OSU-LRAM/DASHBoard/ATxMega64A4U_DASH/README.txt

Bluetooth Device ID:
RNBT-990E

Authentification is:
1234
