OSU-LRAM/DASHBoard/ATxMega64A4U_DASH/Final Bill of Materials.xlsx

MDrive BOM
Component | Part # | Supplier PN | Supplier | Quanity needed | Price for 100 | TOTAL
Motor Driver | DRV8835DSSR | 296-30391-1-ND (http://www.digikey.com/product-detail/en/texas-instruments/DRV8835DSSR/296-30391-1-ND/3188673) | Digikey | 1 | 1.3797 | 1.3797
P-CH Mosfet | MTM231232LBF | MTM231232LBFCT-ND (http://www.digikey.com/product-detail/en/panasonic-electronic-components/MTM231232LBF/MTM231232LBFCT-ND/4864487) | Digikey | 1 | 0.2214 | 0.2214
Motor Header | SM04B-SRSS-TB(LF)(SN) | 455-1804-1-ND (http://www.digikey.com/product-detail/en/jst-sales-america-inc/SM04B-SRSS-TB(LF)(SN)/455-1804-1-ND/926875) | Digikey | 1 | 0.4360 | 0.436
MH crimp | 04SR-3S | 455-2185-ND (http://www.digikey.com/product-detail/en/04SR-3S/455-2185-ND/1300344) | Digikey | 1 | 0.2419 | 0.2419
10uF | CC0805ZKY5V6BB106 | 311-1355-1-ND (http://www.digikey.com/product-detail/en/yageo/CC0805ZKY5V6BB106/311-1355-1-ND/2103139) | Digikey | 1 | 0.0559 | 0.0559
0.1uF | CC0603ZRY5V9BB104 | 311-1343-1-ND (http://www.digikey.com/product-detail/en/yageo/CC0603ZRY5V9BB104/311-1343-1-ND/2103127) | Digikey | 1 | 0.0082 | 0.0082
33K | RC0603JR-0733KL | 311-33KGRCT-ND (http://www.digikey.com/product-detail/en/RC0603JR-0733KL/311-33KGRCT-ND/729719) | Digikey | 1 | 0.0044 | 0.0044
68K | RC0603JR-0768KL | 311-68KGRCT-ND (http://www.digikey.com/product-detail/en/yageo/RC0603JR-0768KL/311-68KGRCT-ND/729769) | Digikey | 1 | 0.0044 | 0.0044
 |  |  |  |  |  |  | 2.3519
BOM_gyro
Component | Part # | Supplier PN | Supplier | Quantity Needed | Price for 100 | Total
0.1uF Capacitor | CC0603ZRY5V9BB104 | 311-1343-1-ND (http://www.digikey.com/product-detail/en/CC0603ZRY5V9BB104/311-1343-1-ND/2103127) | Digikey | 1 | 0.0082 | 0.0082
10uF Capacitor | CC0805ZKY5V6BB106 | 311-1355-1-ND (http://www.digikey.com/product-detail/en/CC0805ZKY5V6BB106/311-1355-1-ND/2103139) | Digikey | 1 | 0.0559 | 0.0559
10nF Capacitor | CC0603KRX7R9BB103 | 311-1085-1-ND (http://www.digikey.com/product-detail/en/CC0603KRX7R9BB103/311-1085-1-ND/302995) | Digikey | 1 | 0.0081 | 0.0081
3-Axis Gyro | L3GD20HTR | 497-13931-1-ND (http://www.digikey.com/product-detail/en/stmicroelectronics/L3GD20HTR/497-13931-1-ND/4357644) | Digikey | 1 | 2.5185 | 2.5185
 |  |  |  |  |  |  | 2.5907
BOM_BT
Component | Part # | Supplier PN | Supplier | Quantity Needed | Price for 100
Bluetooth Module | RN42HID-I/RM | RN42HID-I/RM-ND (http://www.digikey.com/product-detail/en/microchip-technology/RN42HID-I%2FRM/RN42HID-I%2FRM-ND/3597485) | Digikey | 1 | 13.9624 | 13.9624
100K Resistor | ERJ-3EKF1003V | P100KHCT-ND (http://www.digikey.com/product-search/en?keywords=P100KHCT-ND) | Digikey | 2 | 0.0084 | 0.0168
470R Resistor | RC0603JR-07470RL (http://www.digikey.com/product-detail/en/RC0603JR-07470RL/311-470GRCT-ND/729738) | 311-470GRCT-ND (http://www.digikey.com/product-detail/en/RC0603JR-07470RL/311-470GRCT-ND/729738) | Digikey | 2 | 0.0044 | 0.0088
LED Red | LTST-C190CKT | 160-1181-1-ND (http://www.digikey.com/product-detail/en/LTST-C190CKT/160-1181-1-ND/269253) | Digikey | 1 | 0.1374 | 0.1374
LED Green | LTST-C190GKT | 160-1183-1-ND (http://www.digikey.com/product-detail/en/LTST-C190GKT/160-1183-1-ND/269255) | Digikey | 1 | 0.1128 | 0.1128
 |  |  |  |  |  |  | 14.2382
BOM_Batt
Component | Part # | Supplier PN | Supplier | Quantity Needed | Price for 100
Connector Header | SM02B-SRSS-TB(LF)(SN) | 455-1802-1-ND (http://www.digikey.com/product-detail/en/SM02B-SRSS-TB(LF)(SN)/455-1802-1-ND/926873) | Digikey | 1 | 0.3393 | 0.3393
Connector Receptacle | 02SR-3S | 455-2183-ND (http://www.digikey.com/product-detail/en/jst-sales-america-inc/02SR-3S/455-2183-ND/1300342) | Digikey | 1 | 0.1800 | 0.18
Battery | TP125-1SPL25UM (http://www.thunderpowerrc.com/Products/Ultra-Micro/125mAh-1-CELL-1S-3-7V-G4-PRO-LITE-25C-LIPO-ULTRA-MICRO) | TP125-1SPL25UM (http://www.thunderpowerrc.com/Products/Ultra-Micro/125mAh-1-CELL-1S-3-7V-G4-PRO-LITE-25C-LIPO-ULTRA-MICRO) | ThunderPWR | 1 | 2.9900 | 2.99
LED Green | LTST-C190GKT | 160-1183-1-ND (http://www.digikey.com/product-detail/en/LTST-C190GKT/160-1183-1-ND/269255) | Digikey | 1 | 0.1128 | 0.1128
470 resistor | RC0603JR-07470RL (http://www.digikey.com/product-detail/en/RC0603JR-07470RL/311-470GRCT-ND/729738) | 311-470GRCT-ND (http://www.digikey.com/product-detail/en/RC0603JR-07470RL/311-470GRCT-ND/729738) | Digikey | 1 | 0.0044 | 0.0044
4.7uF Capacitor | 885012106012 | 732-7909-1-ND (http://www.digikey.com/product-detail/en/885012106012/732-7909-1-ND/5454536) | Digikey | 2 | 0.1285 | 0.257
0.1uF Capacitor | CC0603ZRY5V9BB104 | 311-1343-1-ND (http://www.digikey.com/product-detail/en/CC0603ZRY5V9BB104/311-1343-1-ND/2103127) | Digikey | 1 | 0.0082 | 0.0082
10k resistor | RC0603JR-0710KL | 311-10KGRCT-ND (http://www.digikey.com/product-detail/en/RC0603JR-0710KL/311-10KGRCT-ND/729647) | Digikey | 1 | 0.0044 | 0.0044
Charging IC | MCP73831T-2ACI/OT | MCP73831T-2ACI/OTCT-ND (http://www.digikey.com/product-detail/en/MCP73831T-2ACI%2FOT/MCP73831T-2ACI%2FOTCT-ND/1979802) | Digikey | 1 | 0.4200 | 0.42
 |  |  |  |  |  |  | 4.3161
BOM_AVS
Component | Part # | Supplier PN | Supplier | Quantity Needed | Price for 100
10nF Capacitor | 885012206014 | 732-7933-1-ND (http://www.digikey.com/product-detail/en/wurth-electronics-inc/885012206014/732-7933-1-ND/5454560) | Digikey | 1 | 0.0693 | 0.0693
Ferrite Bead | BLM18AG121SN1D | 490-1011-1-ND (http://www.digikey.com/product-detail/en/murata-electronics-north-america/BLM18AG121SN1D/490-1011-1-ND/584459) | Digikey | 1 | 0.0476 | 0.0476
Micro USB | 473460001 | WM17141CT-ND (http://www.digikey.com/product-detail/en/molex-llc/0473460001/WM17141CT-ND/1782474) | Digikey | 1 | 0.7563 | 0.7563
100k Resistor | ERJ-3EKF1003V | P100KHCT-ND (http://www.digikey.com/product-search/en?keywords=P100KHCT-ND) | Digikey | 1 | 0.0084 | 0.0084
P-CH Mosfet | MTM231232LBF | MTM231232LBFCT-ND (http://www.digikey.com/product-detail/en/panasonic-electronic-components/MTM231232LBF/MTM231232LBFCT-ND/4864487) | Digikey | 1 | 0.2214 | 0.2214
Schottky Diode | SD0805S020S1R0 | 478-7800-1-ND (http://www.digikey.com/product-detail/en/avx-corporation/SD0805S020S1R0/478-7800-1-ND/3749510) | Digikey | 1 | 0.2166 | 0.2166
TVS Diode | PRTR5v0u2x | 568-4140-1-ND (http://www.digikey.com/product-detail/en/nxp-semiconductors/PRTR5V0U2X,215/568-4140-1-ND/1589981) | Digikey | 1 | 0.3347 | 0.3347
 |  |  |  |  |  |  | 1.6543
BOM_Vreg
Component | Part # | Supplier PN | Supplier | Quantity Needed | Price for 100
LED Green | LTST-C190GKT | 160-1183-1-ND (http://www.digikey.com/product-detail/en/LTST-C190GKT/160-1183-1-ND/269255) | Digikey | 1 | 0.1128 | 0.1128
Switch | JS202011SCQN | 401-2002-1-ND (http://www.digikey.com/product-detail/en/JS202011SCQN/401-2002-1-ND/1640098) | Digikey | 1 | 0.3674 | 0.3674
470 resistor | RC0603JR-07470RL (http://www.digikey.com/product-detail/en/RC0603JR-07470RL/311-470GRCT-ND/729738) | 311-470GRCT-ND (http://www.digikey.com/product-detail/en/RC0603JR-07470RL/311-470GRCT-ND/729738) | Digikey | 1 | 0.0044 | 0.0044
1uF Capcaitor | 885012206026 | 732-7945-1-ND (http://www.digikey.com/product-detail/en/885012206026/732-7945-1-ND/5454572) | Digikey | 3 | 0.0796 | 0.2388
LDO | BU33SD2MG-MTR | BU33SD2MGMCT-ND (http://www.digikey.com/product-search/en?keywords=BU33SD2MGMCT-ND) | Digikey | 1 | 0.3699 | 0.3699
 |  |  |  |  |  |  | 1.0933
BOM_Mr
Component | Part # | Supplier PN | Supplier | Quantity Needed | Price for 100
Magnetic Encoder | 2598 | Pololu (https://www.pololu.com/product/2598) | Pololu | 1 | 5.950 | 5.95
Coreless Motor |  | Amazon (http://www.amazon.com/Coreless-Motor-6x12mm-DC3-7V-45000RPM/dp/B00QC2EWUO) | Amazon | 1 | 4.510 | 4.51
Header | SM04B-SRSS-TB(LF)(SN) | 455-1804-1-ND (http://www.digikey.com/product-detail/en/jst-sales-america-inc/SM04B-SRSS-TB(LF)(SN)/455-1804-1-ND/926875) | Digikey | 2 | 0.4360 | 0.872
Header crimp | 04SR-3S | 455-2185-ND (http://www.digikey.com/product-detail/en/04SR-3S/455-2185-ND/1300344) | Digikey | 2 | 0.2419 | 0.4838
 |  |  |  |  |  |  | 11.8158
BOM_Ml
Component | Part # | Supplier PN | Supplier | Quantity Needed | Price for 100
Magnetic Encoder | 2598 | Pololu (https://www.pololu.com/product/2598) | Pololu | 1 | 5.950 | 5.95
Coreless Motor |  | Amazon (http://www.amazon.com/Coreless-Motor-6x12mm-DC3-7V-45000RPM/dp/B00QC2EWUO) | Amazon | 1 | 4.510 | 4.51
Header | SM04B-SRSS-TB(LF)(SN) | 455-1804-1-ND (http://www.digikey.com/product-detail/en/jst-sales-america-inc/SM04B-SRSS-TB(LF)(SN)/455-1804-1-ND/926875) | Digikey | 2 | 0.4360 | 0.872
Header crimp | 04SR-3S | 455-2185-ND (http://www.digikey.com/product-detail/en/04SR-3S/455-2185-ND/1300344) | Digikey | 2 | 0.2419 | 0.4838
 |  |  |  |  |  |  | 11.8158
BOM_Micro
Component | Part # | Supplier PN | Supplier | Quantity Needed | Price for 100
0.1uF Capacitor | CC0603ZRY5V9BB104 | 311-1343-1-ND (http://www.digikey.com/product-detail/en/CC0603ZRY5V9BB104/311-1343-1-ND/2103127) | Digikey | 4 | 0.0082 | 0.0328
10nH Inductor | 744786110A | 732-6263-1-ND (http://www.digikey.com/product-detail/en/744786110A/732-6263-1-ND/5087226) | Digikey | 1 | 0.0950 | 0.095
100K Resistor | ERJ-3EKF1003V | P100KHCT-ND (http://www.digikey.com/product-search/en?keywords=P100KHCT-ND) | Digikey | 2 | 0.0084 | 0.0168
Push Button | 1.14100.5030000 | CKN9363CT-ND (http://www.digikey.com/product-detail/en/1.14100.5030000/CKN9363CT-ND/583462) | Digikey | 1 | 2.0004 | 2.0004
ATXMega64 A4U | ATXMEGA64A4U-AU | ATXMEGA64A4U-AU-ND (http://www.digikey.com/product-detail/en/ATXMEGA64A4U-AU/ATXMEGA64A4U-AU-ND/4215304) | Digikey | 1 | 3.5461 | 3.5461
32 kHz Oscillator | FC-12M 32.7680KA-A3 | SER3672CT-ND (http://www.digikey.com/product-detail/en/FC-12M%2032.7680KA-A3/SER3672CT-ND/2403445) | Digikey | 1 | 1.512 | 1.512
 |  |  |  |  |  |  | 7.0753
BOM_Board
Component | Part # | Supplier PN | Supplier | Quantity Needed | Price for 100
Solder Paste | SMD291SNL | SMD291SNL-ND (http://www.digikey.com/product-detail/en/chip-quik-inc/SMD291SNL/SMD291SNL-ND/1160001) | Digikey | 1 | 15.3 | 15.3
Ribbon Cable | 3811/09 300 | MC090M-5-ND (http://www.digikey.com/product-detail/en/3811%2F09%20300/MC090M-5-ND/4312054) | Digikey | 3 | 2.862 | 8.586
Solder Stencil |  |  | OSH Stencil | 1 | 5.85 | 5.85
PCB |  |  | OSH Park | 1 | 11.67 | 11.67
 |  |  |  |  |  |  | 41.406
 |  |  |  |  |  |  | Total
 |  |  |  |  |  |  | $98.36
Substitute Parts
BT Alternate |  | 740-1038-ND (http://www.digikey.com/scripts/DkSearch/dksus.dll?Detail&itemSeq=194547669&uq=635961646551221085)
Schottky Diode Alternate (500mA) |  | 478-7799-1-ND (http://www.digikey.com/product-detail/en/avx-corporation/SD0805S020S0R5/478-7799-1-ND/3749477)
