OSU-LRAM/DASHBoard/ATxMega64A4U_DASH/PCB/DASH.brd

## EAGLE design ATxMega64A4U_DASH/PCB/DASH.brd (2016-06-20)

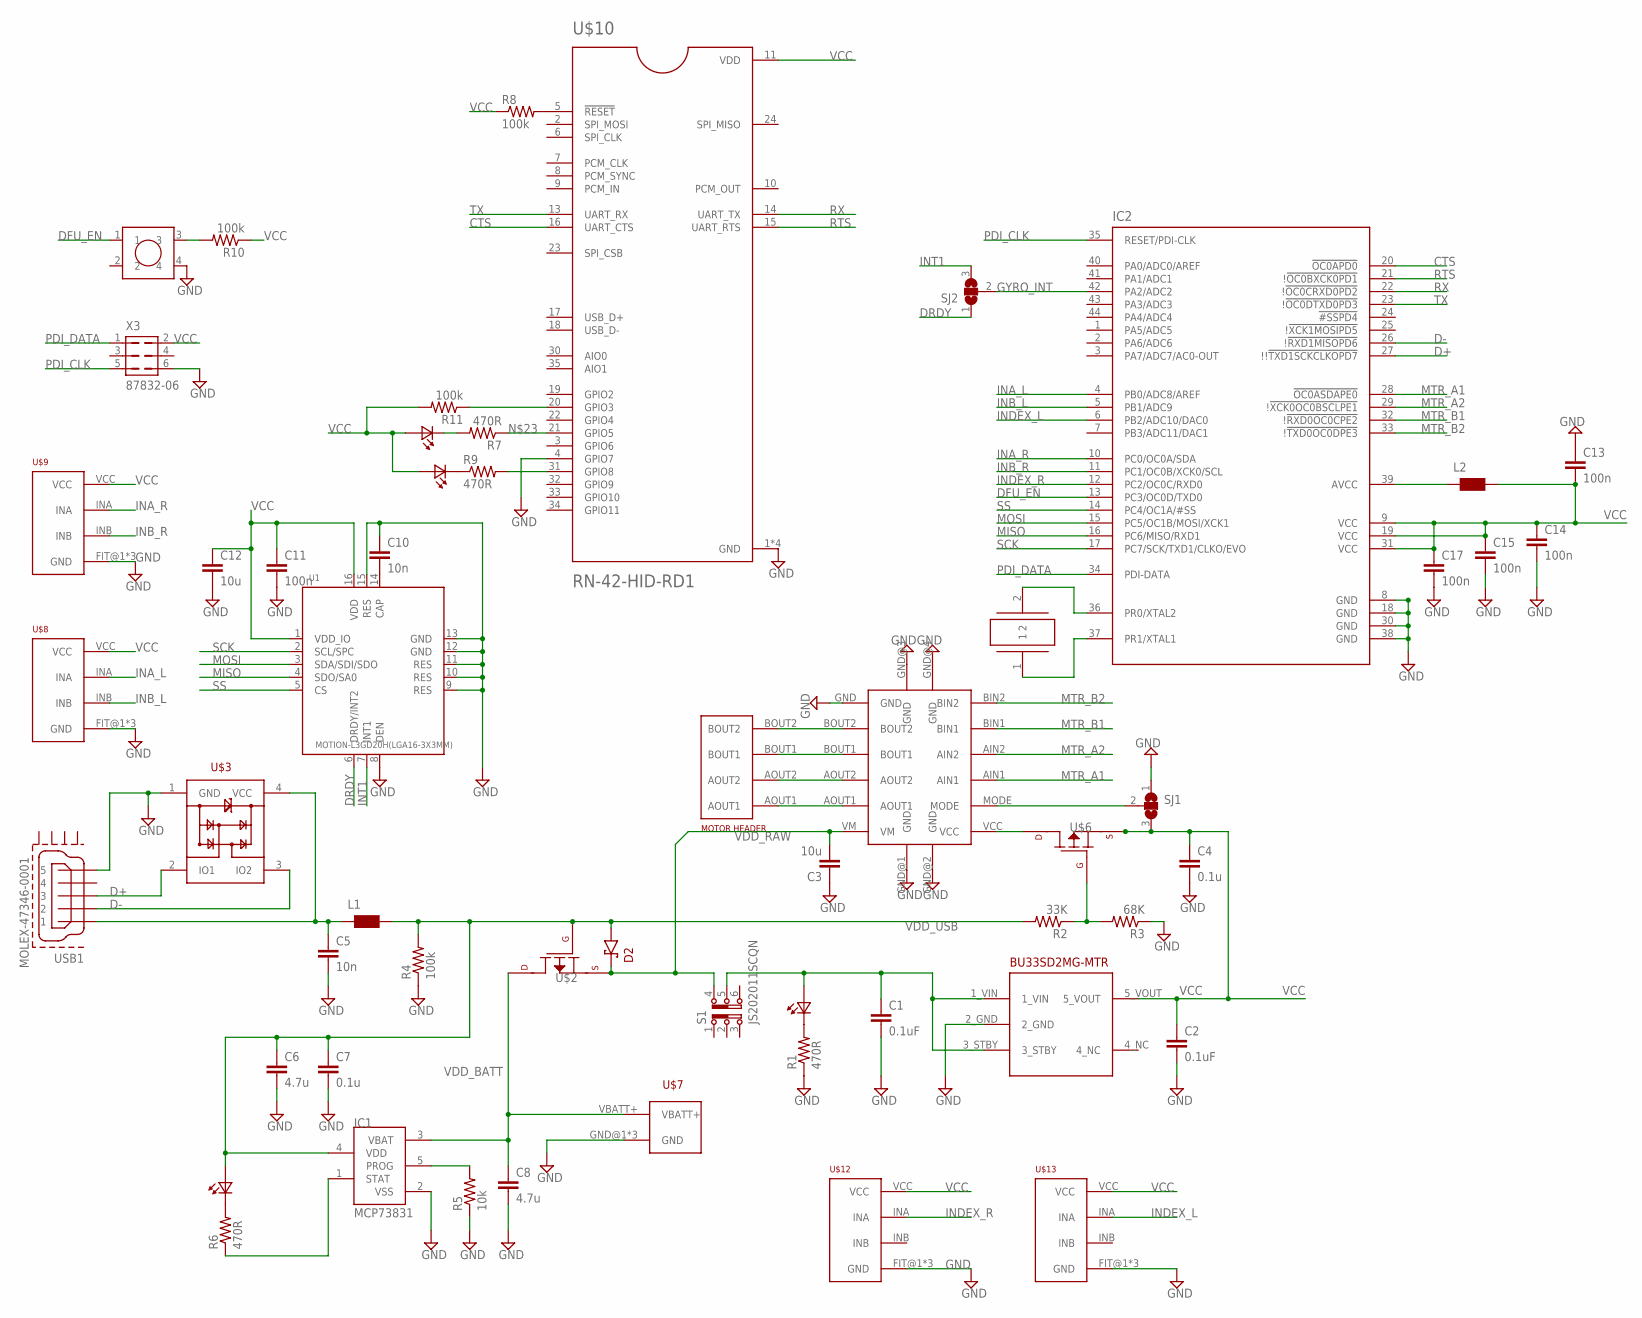
[picture p1: schematic DASH.sch]

Parts:
C1, C2: 0.1uF; 0603-CAP
C3, C12: 10u; C0805
C4, C7: 0.1u; C0603
C5, C10: 10n; C0603
C6, C8: 4.7u; C0603
C11, C13, C14, C15, C17: 100n; C0603
D1, D3, D5, D6: LTST-C190KRKT; 0603
D2: SCHOTTKY_DIODE_0805
IC1: MCP73831; SOT23-5L
IC2: AT-XMEGA-XXA4-AU; QFP80P1200X1200X120-44N
L1, L2: WE-CBF_0603; 0603
R1, R6, R7, R9: 470R; R0603
R2: 33K; R0603
R3: 68K; R0603
R4, R8, R10, R11: 100k; R0603
R5: 10k; R0603
S1: JS202011SCQN
SJ1, SJ2: SJ2W; SJ_2
U1: MOTION-L3GD20H(LGA16-3X3MM); LGA16-0.5-3X3MM
U$1: LDO_BU33SD2-MSURFACE_MOUNT; SSOP5
U$2, U$6: P-FETSMD; SOT-323
U$3: PRTR5V0U2X; SOT143B
U$4: DRV8835
U$5: SMB04-SRSS-TBSMD; SM04B-SRSS-TB
U$7: SM02B-SRSS
U$8, U$9, U$12, U$13: LEFT_ENCODER; SM04B-SRSS-TB
U$10: RN-42-HID-RD1; MICROCHIP_RN-42-HID-RD1
U$11: PUSHBUTTON
U$14: FC-12M_32.7
USB1: MOLEX-47346-0001; MOLEX-47364-0001
X3: 87832-06

Connections:
CTS: IC2.20 (!OC0APD0), U$10.16 (UART_CTS)
D+: IC2.27 (!!!TXD1SCKCLKOPD7), U$3.2 (IO1), USB1.3
D-: IC2.26 (!!RXD1MISOPD6), U$3.3 (IO2), USB1.2
DFU_EN: IC2.13 (PC3/OC0D/TXD0), U$11.1
DRDY: SJ2.1, U1.6 (DRDY/INT2)
GND: C1.2, C2.2, C3.1, C4.2, C5.2, C6.2, C7.2, C8.2, C10.1, C11.2, C12.2, C13.1, C14.2, C15.2, C17.2, IC1.2 (VSS), IC2.8 (GND), IC2.18 (GND), IC2.30 (GND), IC2.38 (GND), R1.1, R3.1, R4.1, R5.1, SJ1.1, U1.8 (DEN), U1.9 (RES), U1.10 (RES), U1.11 (RES), U1.12 (GND), U1.13 (GND), U1.15 (RES), U$1.2_GND, U$3.1 (GND), U$4.GND, U$4.GND@1 (GND), U$4.GND@2 (GND), U$4.GND@3 (GND), U$4.GND@4 (GND), U$4.GND@5 (GND), U$7.GND@1 (GND), U$7.GND@2 (GND), U$7.VBATT- (GND), U$8.FIT@1 (GND), U$8.FIT@2 (GND), U$8.GND, U$9.FIT@1 (GND), U$9.FIT@2 (GND), U$9.GND, U$10.1 (GND), U$10.4 (GPIO7), U$10.12 (GND), U$10.28 (GND), U$10.29 (GND), U$11.4, U$12.FIT@1 (GND), U$12.FIT@2 (GND), U$12.GND, U$13.FIT@1 (GND), U$13.FIT@2 (GND), U$13.GND, USB1.5, X3.6
GYRO_INT: IC2.42 (PA2/ADC2), SJ2.2
INA_L: IC2.4 (PB0/ADC8/AREF), U$8.INA
INA_R: IC2.10 (PC0/OC0A/SDA), U$9.INA
INB_L: IC2.5 (PB1/ADC9), U$8.INB
INB_R: IC2.11 (PC1/OC0B/XCK0/SCL), U$9.INB
INDEX_L: IC2.6 (PB2/ADC10/DAC0), U$13.INA
INDEX_R: IC2.12 (PC2/OC0C/RXD0), U$12.INA
INT1: SJ2.3, U1.7 (INT1)
MISO: IC2.16 (PC6/MISO/RXD1), U1.4 (SDO/SA0)
MOSI: IC2.15 (PC5/OC1B/MOSI/XCK1), U1.3 (SDA/SDI/SDO)
MTR_A1: IC2.28 (!OC0ASDAPE0), U$4.AIN1
MTR_A2: IC2.29 (!!XCK0OC0BSCLPE1), U$4.AIN2
MTR_B1: IC2.32 (!!RXD0OC0CPE2), U$4.BIN1
MTR_B2: IC2.33 (!!TXD0OC0DPE3), U$4.BIN2
unnamed: C1.1, D1.2 (A2), S1.5, U$1.1_VIN, U$1.3_STBY
unnamed: D1.1 (K2), R1.2
unnamed: R10.2, U$11.3
unnamed: U$4.AOUT1, U$5.AOUT1
unnamed: C10.2, U1.14 (CAP)
unnamed: U$4.AOUT2, U$5.AOUT2
unnamed: U$4.BOUT1, U$5.BOUT1
unnamed: U$4.BOUT2, U$5.BOUT2
unnamed: U$4.VCC, U$6.3_DRAIN
unnamed: R2.1, R3.2, U$6.1_GATE
unnamed: SJ1.2, U$4.MODE
unnamed: C5.1, L1.1, U$3.4 (VCC), USB1.1
unnamed: D3.1 (K2), R6.2
unnamed: IC1.5 (PROG), R5.2
unnamed: IC1.1 (STAT), R6.1
unnamed: D5.1 (K2), R7.2
unnamed: D6.1 (K2), R9.1
unnamed: IC2.36 (PR0/XTAL2), U$14.2
unnamed: IC2.37 (PR1/XTAL1), U$14.1
unnamed: IC2.39 (AVCC), L2.1
unnamed: R9.2, U$10.31 (GPIO8)
unnamed: R8.2, U$10.5 (!RESET)
unnamed: R7.1, U$10.21 (GPIO5)
unnamed: R11.1, U$10.20 (GPIO3)
PDI_CLK: IC2.35 (RESET/PDI-CLK), X3.5
PDI_DATA: IC2.34 (PDI-DATA), X3.1
RTS: IC2.21 (!!OC0BXCK0PD1), U$10.15 (UART_RTS)
RX: IC2.22 (!!OC0CRXD0PD2), U$10.14 (UART_TX)
SCK: IC2.17 (PC7/SCK/TXD1/CLKO/EVO), U1.2 (SCL/SPC)
SS: IC2.14 (PC4/OC1A/#SS), U1.5 (CS)
TX: IC2.23 (!!OC0DTXD0PD3), U$10.13 (UART_RX)
VCC: C2.1, C4.1, C11.1, C12.1, C13.2, C14.1, C15.1, C17.1, D5.2 (A2), D6.2 (A2), IC2.9 (VCC), IC2.19 (VCC), IC2.31 (VCC), L2.2, R8.1, R10.1, R11.2, SJ1.3, U1.1 (VDD_IO), U1.16 (VDD), U$1.5_VOUT, U$6.2_SOURCE, U$8.VCC, U$9.VCC, U$10.11 (VDD), U$12.VCC, U$13.VCC, X3.2
VDD_BATT: C8.1, IC1.3 (VBAT), U$2.3_DRAIN, U$7.VBATT+
VDD_RAW: C3.2, D2.1_CATHODE, S1.4, U$2.2_SOURCE, U$4.VM
VDD_USB: C6.1, C7.1, D2.2_ANODE, D3.2 (A2), IC1.4 (VDD), L1.2, R2.2, R4.2, U$2.1_GATE

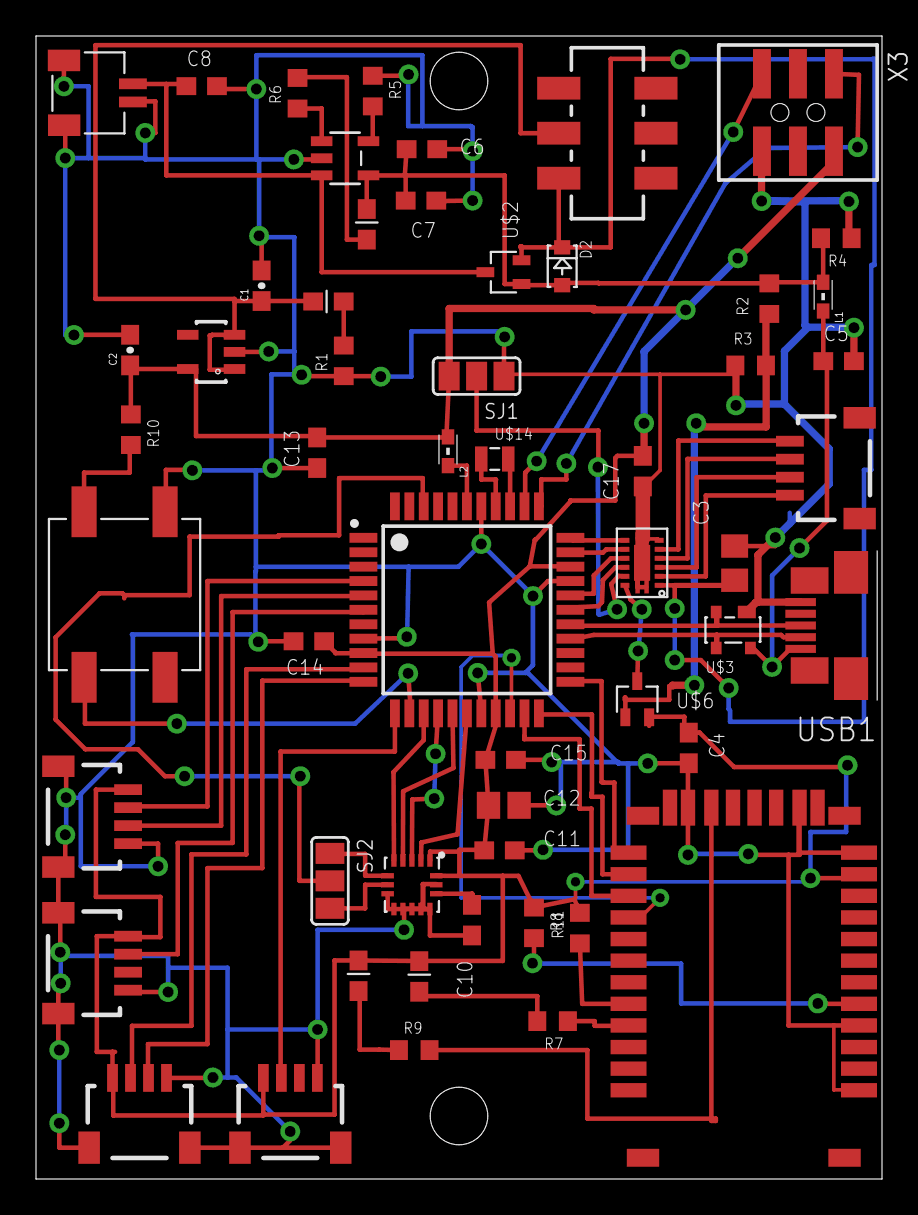
[picture p2: board DASH.brd from above]

Board: 2 copper layers, 47.0 x 63.5 mm, 55 parts (0 on the bottom side), 55 nets.
