OSU-LRAM/DASHBoard/ATxMega64A4U_DASH/DASH_2.0_Errata.docx

DASH 2.0 Errata

1. Microcontroller Brownout

When the battery on the DASH dies (voltage drops below operating threshold) the program memory on the microcontroller may become corrupted. The specifics of the failure are not well understood, but a quick reprogramming of the DASH seems to fix the problem.

2. LED Silkscreen Reversed

There are markings on the PCB that indicate the direction the LED’s are to be placed. These markings were found to be backwards. When populating the DASH 2.0 PCBs, the LEDs should be placed opposite of the indicated polarity on the silkscreen.

3. Resistor R11

Placement of the resistor R11 will put the bluetooth module in an undesired non-slave state called “Auto-discovery mode”. Due to this, R11 should be left out of the circuit.
