OSU-LRAM/DASHBoard/ATxMega64A4U_DASH/Atmel Studios Project/ATxMega64A4U_DASH/src/ASF/common/boards/user_board/user_board.h

/**
 * \file
 *
 * \brief User board definition template
 *
 */

 /* This file is intended to contain definitions and configuration details for
 * features and devices that are available on the board, e.g., frequency and
 * startup time for an external crystal, external memory devices, LED and USART
 * pins.
 */

#ifndef USER_BOARD_H
#define USER_BOARD_H

#include <conf_board.h>

// External oscillator settings.
// Uncomment and set correct values if external oscillator is used.

// External oscillator frequency
//#define BOARD_XOSC_HZ          8000000

// External oscillator type.
//!< External clock signal
//#define BOARD_XOSC_TYPE        XOSC_TYPE_EXTERNAL
//!< 32.768 kHz resonator on TOSC
//#define BOARD_XOSC_TYPE        XOSC_TYPE_32KHZ
//!< 0.4 to 16 MHz resonator on XTALS
//#define BOARD_XOSC_TYPE        XOSC_TYPE_XTAL

// External oscillator startup time
//#define BOARD_XOSC_STARTUP_US  500000

#define PE0 IOPORT_CREATE_PIN(PORTE, 0)
#define PE1 IOPORT_CREATE_PIN(PORTE, 1)
#define PE2 IOPORT_CREATE_PIN(PORTE, 2)
#define PE3 IOPORT_CREATE_PIN(PORTE, 3)

#endif // USER_BOARD_H
