OSU-LRAM/DASHBoard/(notices)

Notices in the files:
parts and their libraries:
switch-ck: Copyright (C) 2011, Bob Starr
SparkFun-Capacitors: Licensing: Creative Commons ShareAlike 4.0 International - https://creativecommons.org/licenses/by-sa/4.0
wuerth-elektronik: Copyright: Würth Elektronik eiSos
